CarlosNinaOchoa/yachaq-robot/documentacion/docs/img/pie-03.jpg

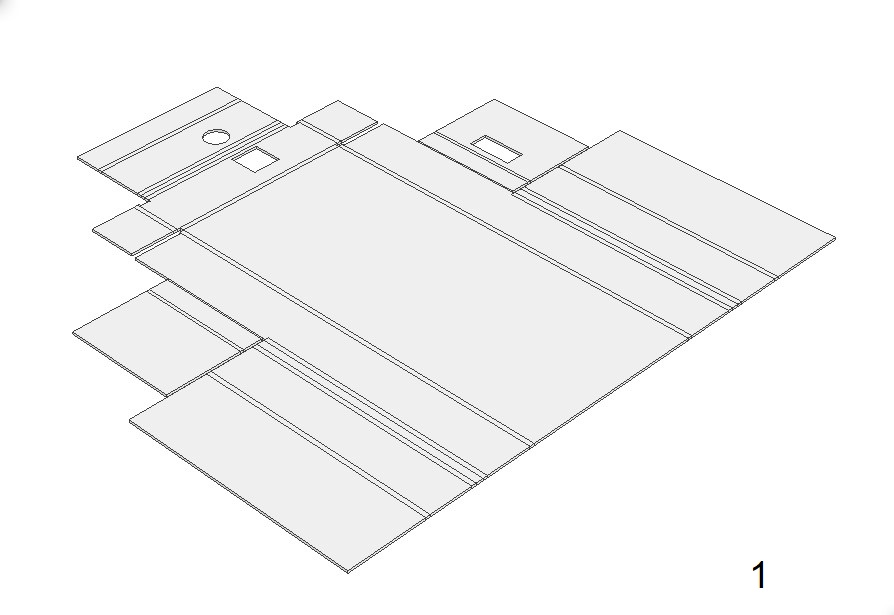
documentacion/docs/img/pie-03.jpg
