CarlosNinaOchoa/yachaq-robot/documentacion/docs/img/pie-04.jpg

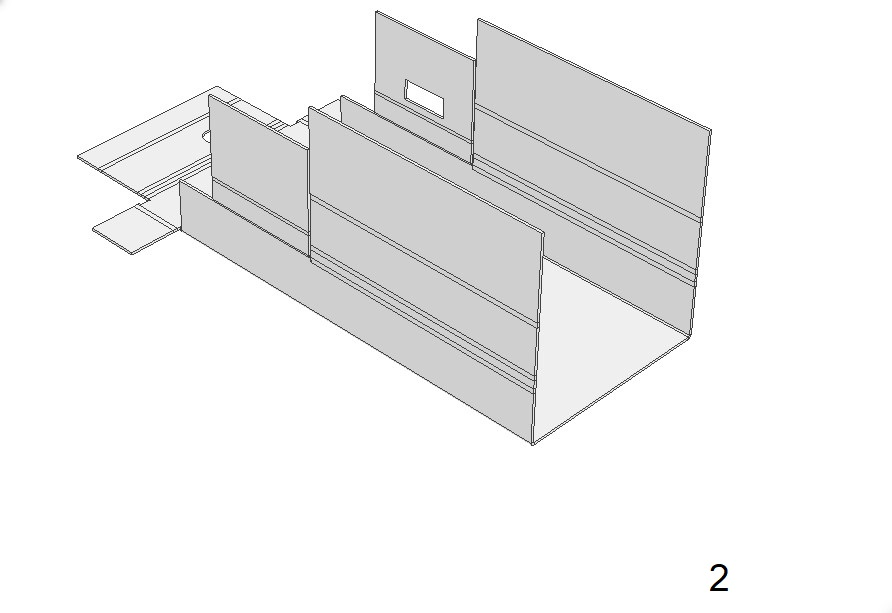
documentacion/docs/img/pie-04.jpg
