CarlosNinaOchoa/yachaq-robot/documentacion/docs/img/pie-07.jpg

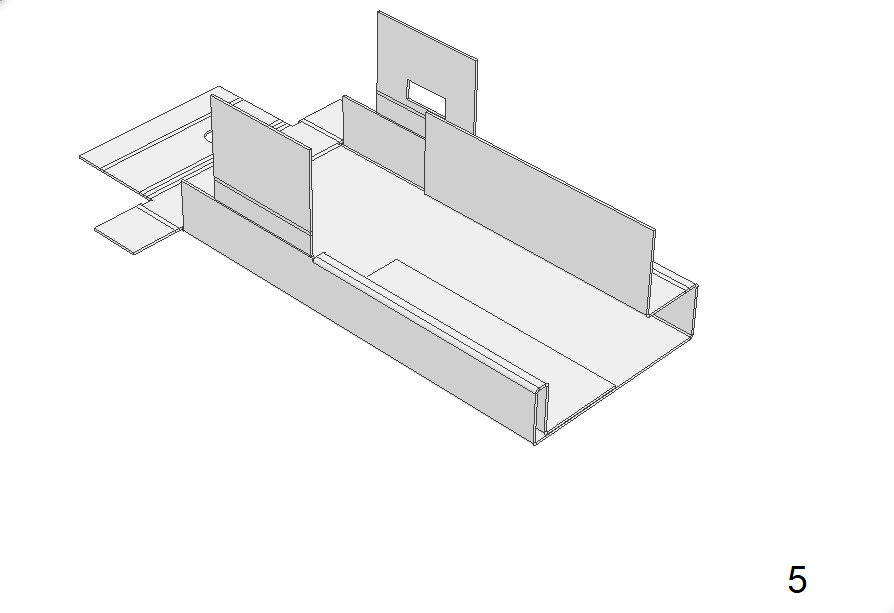
documentacion/docs/img/pie-07.jpg
