CarlosNinaOchoa/yachaq-robot/documentacion/docs/img/pie-09.jpg

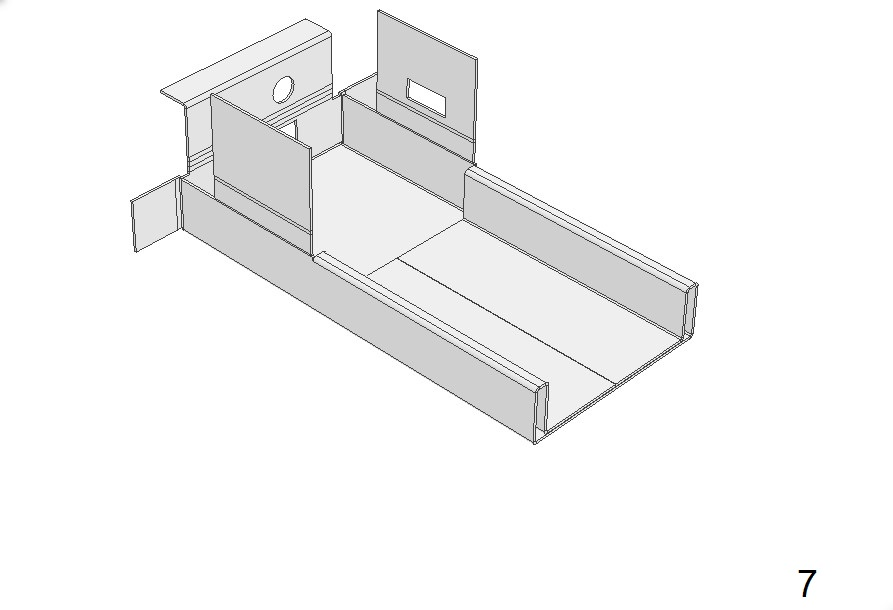
documentacion/docs/img/pie-09.jpg
