CarlosNinaOchoa/yachaq-robot/documentacion/docs/img/repository-header.png

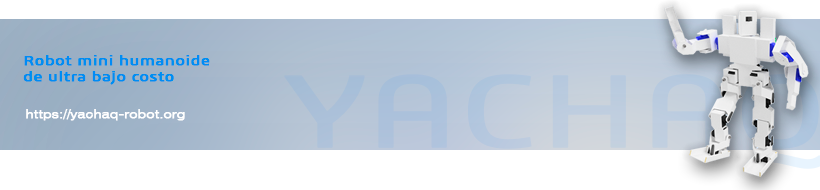
documentacion/docs/img/repository-header.png
