CarlosNinaOchoa/yachaq-robot/documentacion/docs/img/servos-mg90s-driver-esp32-cam.jpg

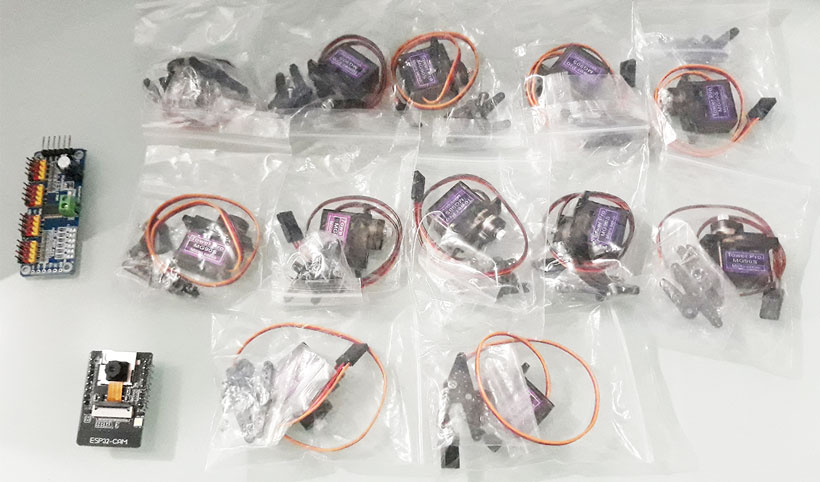
documentacion/docs/img/servos-mg90s-driver-esp32-cam.jpg
