CarlosNinaOchoa/yachaq-robot/documentacion/docs/construccion-4.md

---
page_title: Inicio
page_description: Yachaq, busca democratizar la robótica humanoide, mediante un hardware de ultra bajo costo.
page_author: Carlos Nina Ochoa, Roxana Gómez Romero
page_date: 2021-07-05
---

# Etapa 4: Ensamblaje

Aún estamos construyendo este contenido, por favor vuelva pronto.

Nombres de servos
