CarlosNinaOchoa/yachaq-robot/mecanica/MiniHumanoidLowCostRobot-v1.1-General-Assembly.pdf

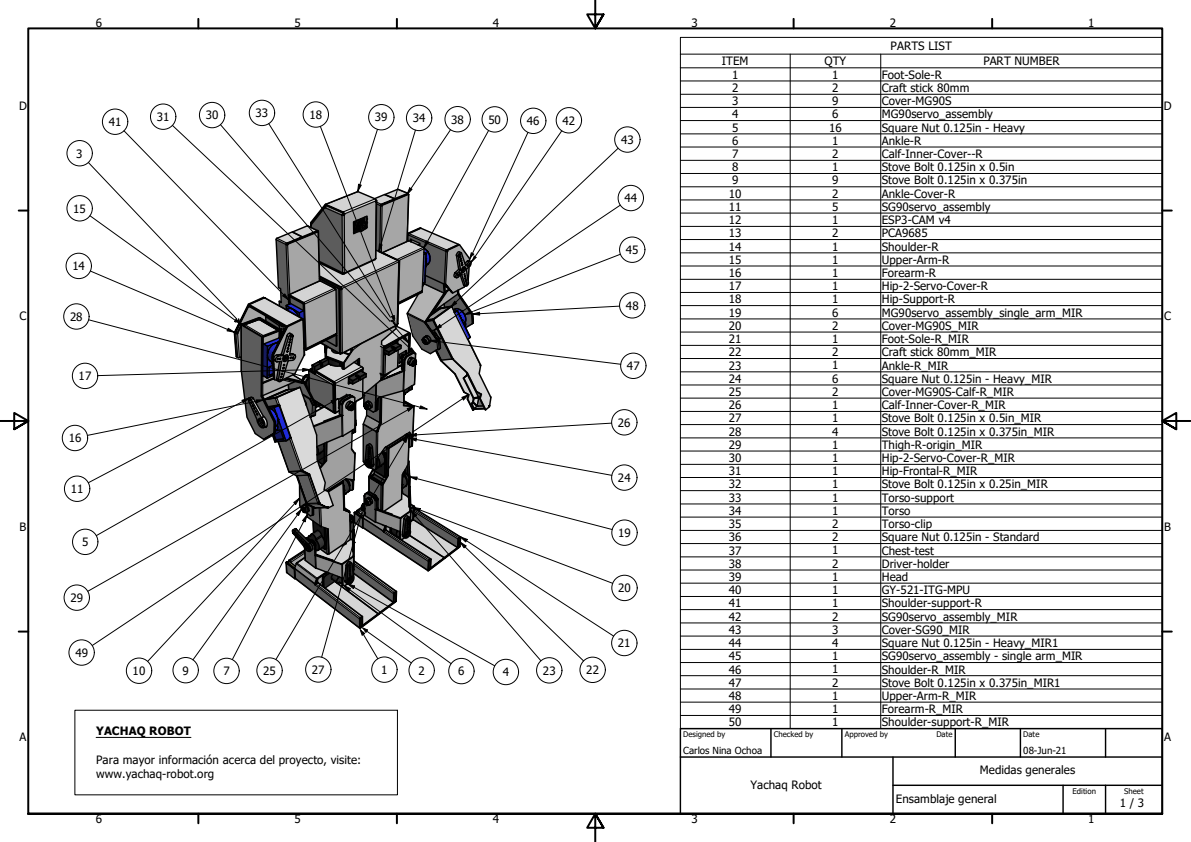
[picture p32: page 1]

I T E M | Q T Y | P A R T N U M B E R
1 | 1 | F o o t -S ole -R
2 | 2 | C r a ft s t i c k 8 0 m m
3 | 9 | C o v e r -M G 9 0 S
4 | 6 | M G 9 0 s e r v o _ a s s e m bly
5 | 1 6 | S q u a r e N u t 0 . 1 2 5 i n -H e a v y
6 | 1 | A n kle -R
7 | 2 | C alf -I n n e r -C o v e r --R
8 | 1 | S t o v e B olt 0 . 1 2 5 i n x 0 . 5 i n
9 | 9 | S t o v e B olt 0 . 1 2 5 i n x 0 . 3 7 5 i n
1 0 | 2 | A n kle -C o v e r -R
1 1 | 5 | S G 9 0 s e r v o _ a s s e m bly
1 2 | 1 | E S P 3 -C A M v 4
1 3 | 2 | P C A 9 6 8 5
1 4 | 1 | S h o uld e r -R
1 5 | 1 | U p p e r -A r m -R

1 6 | 1 | F o r e a r m -R
1 7 | 1 | H i p -2 -S e r v o -C o v e r -R
1 8 | 1 | H i p -S u p p o r t -R
1 9 | 6 | M G 9 0 s e r v o _ a s s e m bly _ s i n gle _ a r m _ M I R
2 0 | 2 | C o v e r -M G 9 0 S _ M I R
2 1 | 1 | F o o t -S ole -R_ M I R
2 2 | 2 | C r a ft s t i c k 8 0 m m _ M I R
2 3 | 1 | A n kle -R_ M I R
2 4 | 6 | S q u a r e N u t 0 . 1 2 5 i n -H e a v y_ M I R
2 5 | 2 | C o v e r -M G 9 0 S -C alf -R_ M I R
2 6 | 1 | C alf -I n n e r -C o v e r -R_ M I R
2 7 | 1 | S t o v e B olt 0 . 1 2 5 i n x 0 . 5 i n _ M I R
2 8 | 4 | S t o v e B olt 0 . 1 2 5 i n x 0 . 3 7 5 i n _ M I R
2 9 | 1 | T h i g h -R -o r i g i n _ M I R
3 0 | 1 | H i p -2 -S e r v o -C o v e r -R_ M I R
3 1 | 1 | H i p -F r o n t al-R_ M I R
3 2 | 1 | S t o v e B olt 0 . 1 2 5 i n x 0 . 2 5 i n _ M I R
3 3 | 1 | T o r s o -s u p p o r t
3 4 | 1 | T o r s o
3 5 | 2 | T o r s o -cli p
3 6 | 2 | S q u a r e N u t 0 . 1 2 5 i n -S t a n d a r d
3 7 | 1 | C h e s t -t e s t
3 8 | 2 | D r i v e r -h old e r
3 9 | 1 | H e a d
4 0 | 1 | G Y -5 2 1 -I T G -M P U
4 1 | 1 | S h o uld e r -s u p p o r t -R
4 2 | 2 | S G 9 0 s e r v o _ a s s e m bly_ M I R
4 3 | 3 | C o v e r -S G 9 0 _ M I R
4 4 | 4 | S q u a r e N u t 0 . 1 2 5 i n -H e a v y_ M I R 1

4 5 | 1 | S G 9 0 s e r v o _ a s s e m bly -s i n gle a r m _ M I R
4 6 | 1 | S h o uld e r -R_ M I R
4 7 | 2 | S t o v e B olt 0 . 1 2 5 i n x 0 . 3 7 5 i n _ M I R 1
4 8 | 1 | U p p e r -A r m -R_ M I R
4 9 | 1 | F o r e a r m -R_ M I R
5 0 | 1 | S h o uld e r -s u p p o r t -R_ M I R

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

M e d i d a s g e n e r ale s

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

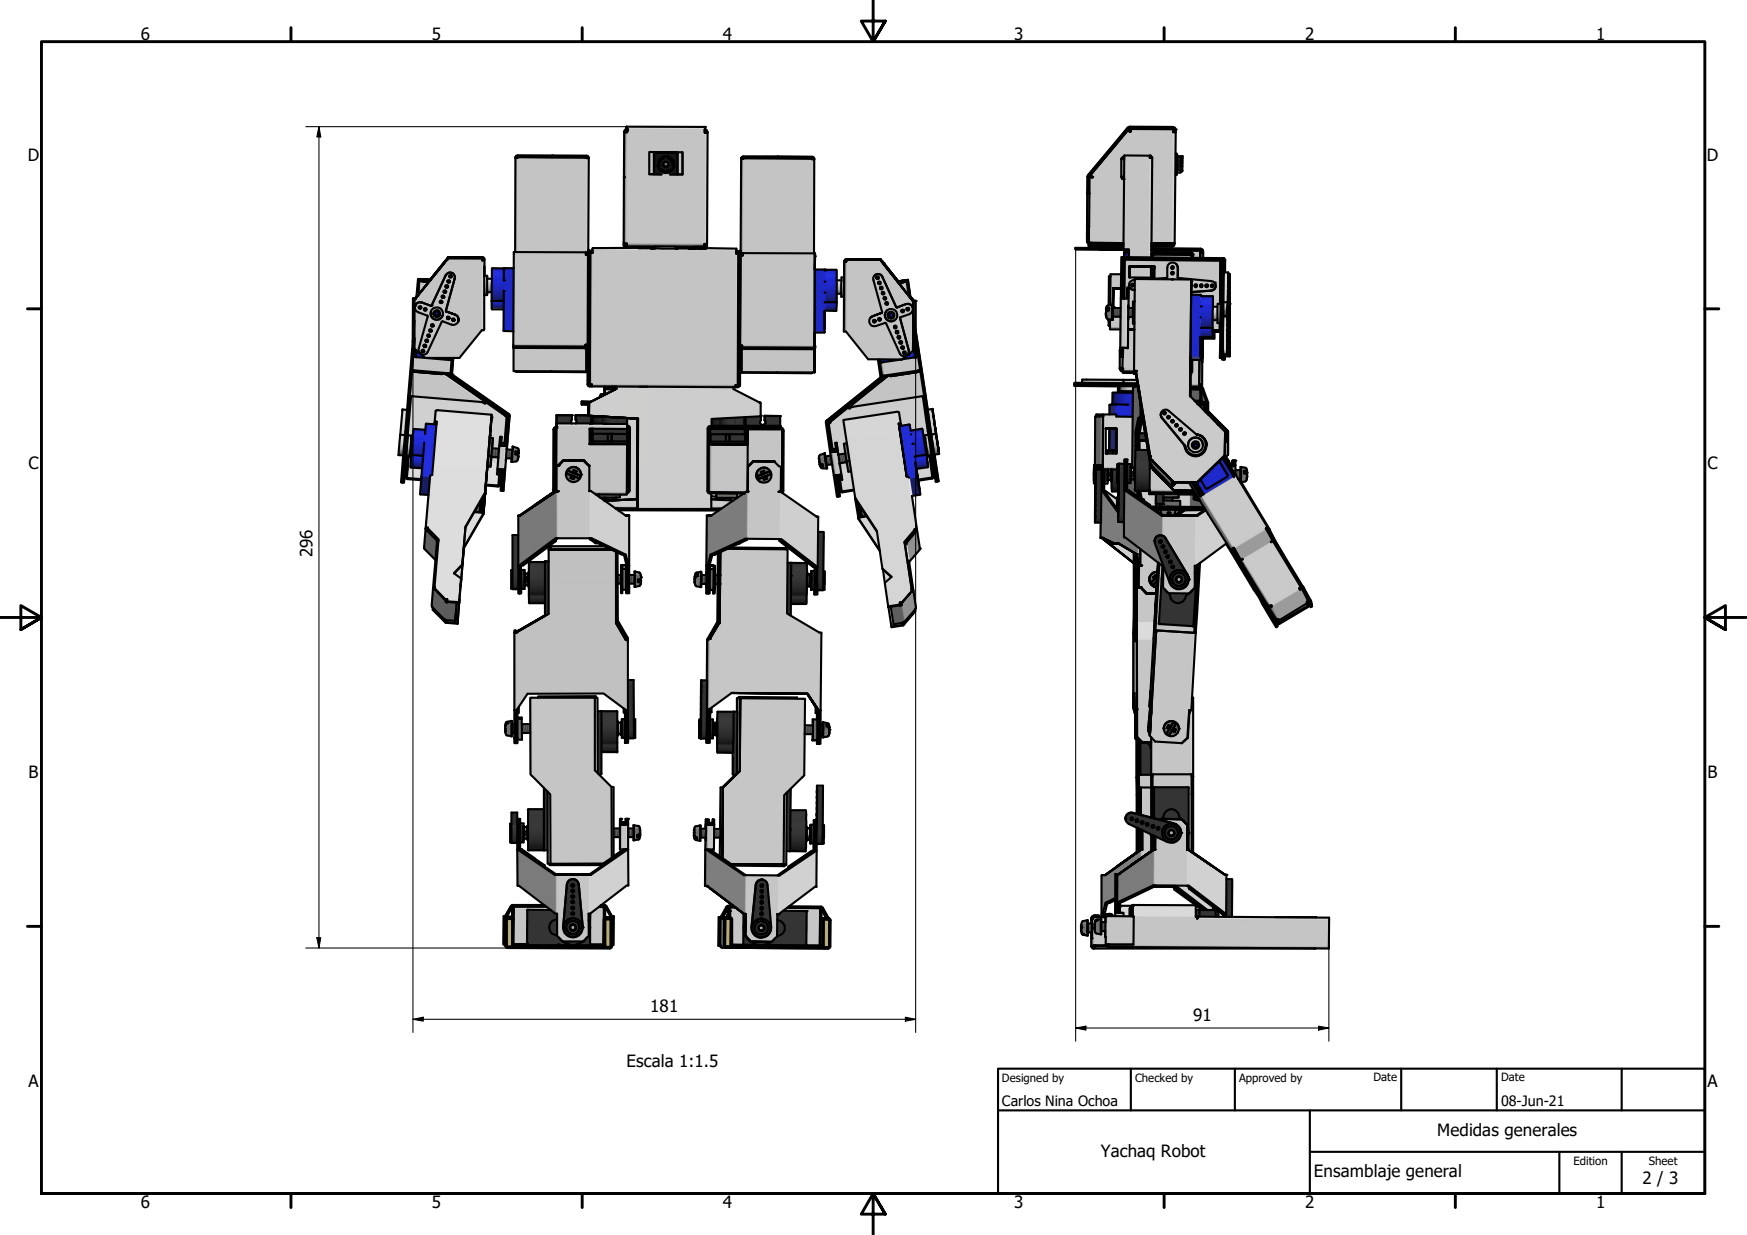
[picture p33: page 2]
Medidas generales; Ensamblaje general; Yachaq Robot; Carlos Nina Ochoa; 08-Jun-21; Designed by; Checked by; Approved by; Date; Escala 1:1.5

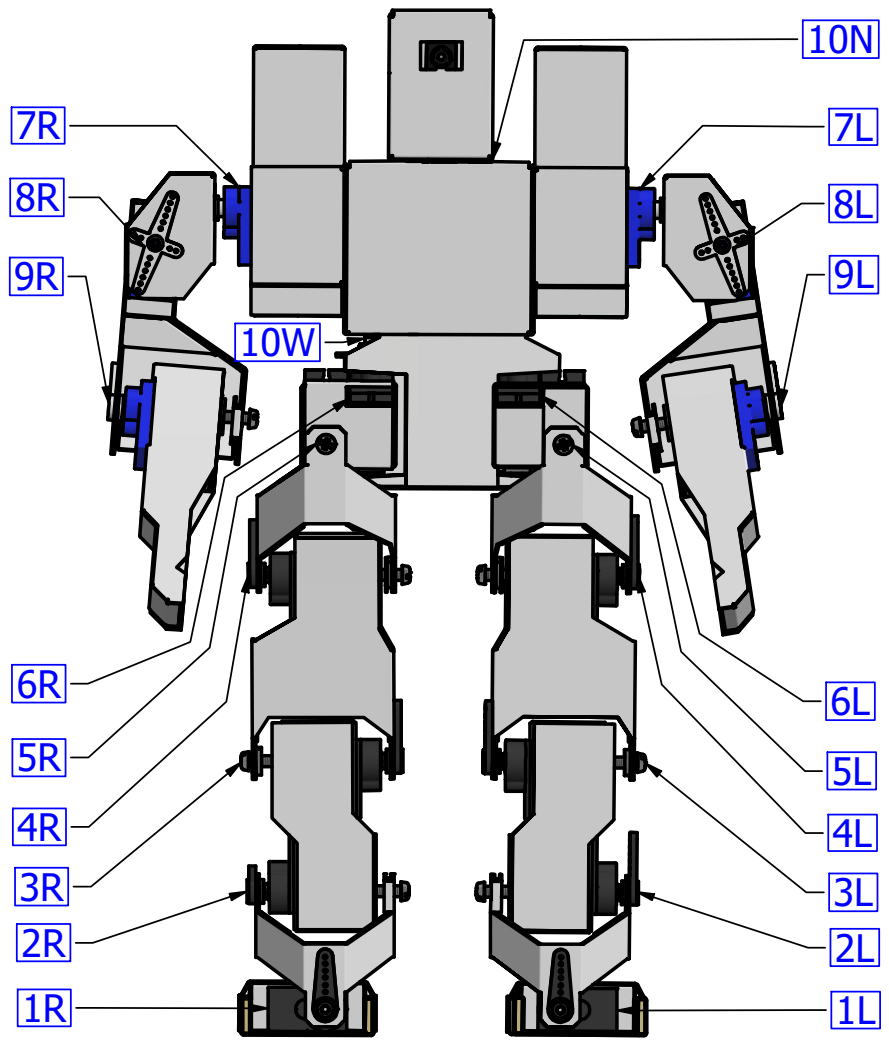
[picture p34: page 3]

Designed by Carlos Nina Ochoa | Checked by | Approved by Date | Date 08-Jun-21

Yachaq Robot | Medidas generales

Ensamblaje general | Edition | Sheet 3 / 3
