CarlosNinaOchoa/yachaq-robot/documentacion/docs/img/calibracion-01.jpg

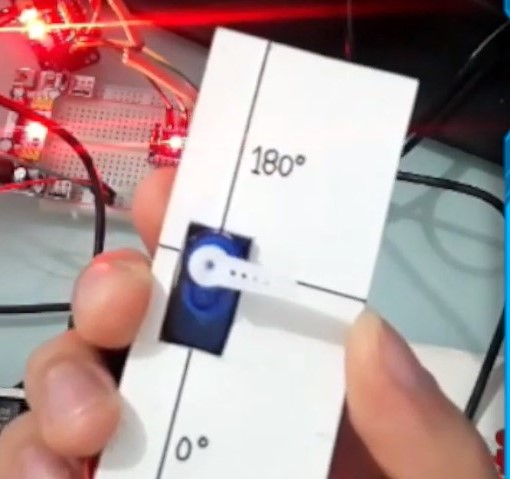
documentacion/docs/img/calibracion-01.jpg
