CarlosNinaOchoa/yachaq-robot/mecanica/Plantillas de corte v1 - Yachaq robot v1.3.pdf

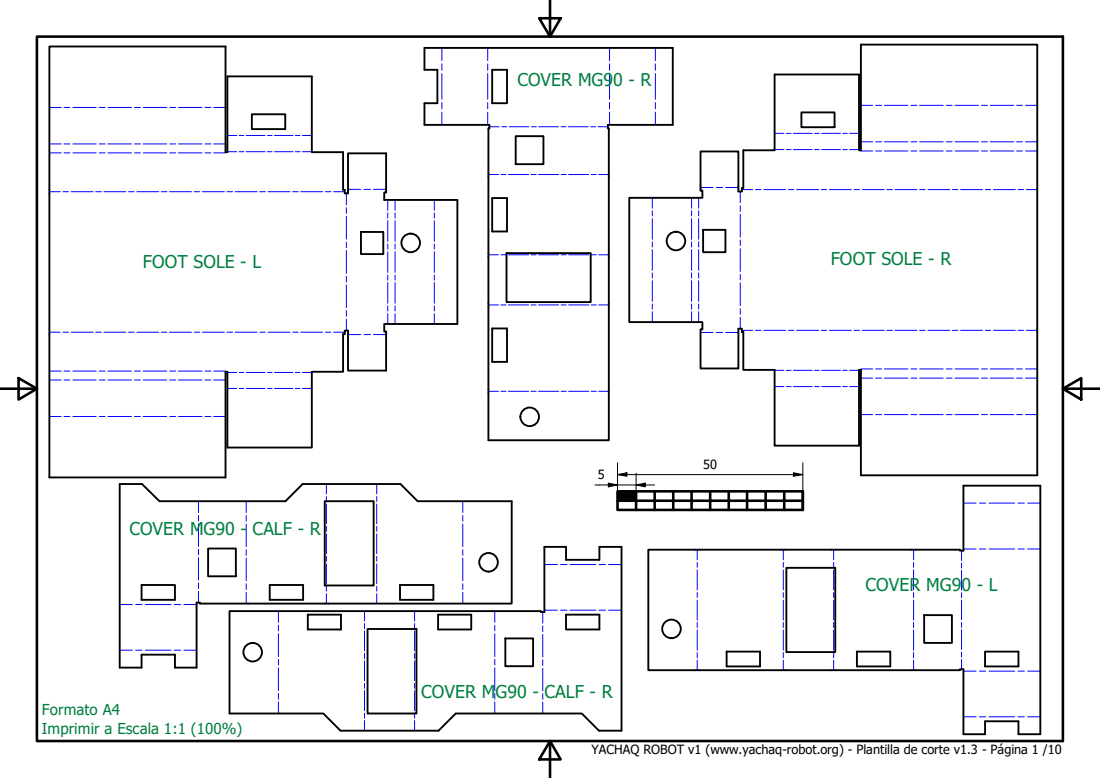
[picture p36: page 1]
FOOT SOLE - L; FOOT SOLE - R; COVER MG90 - R; COVER MG90 - L; COVER MG90 - CALF - R; Formato A4 Imprimir a Escala 1:1 (100%)

YACHAQ ROBOT v1 (www.yachaq-robot.org) - Plantilla de corte v1.3 - Pigina 1 /10

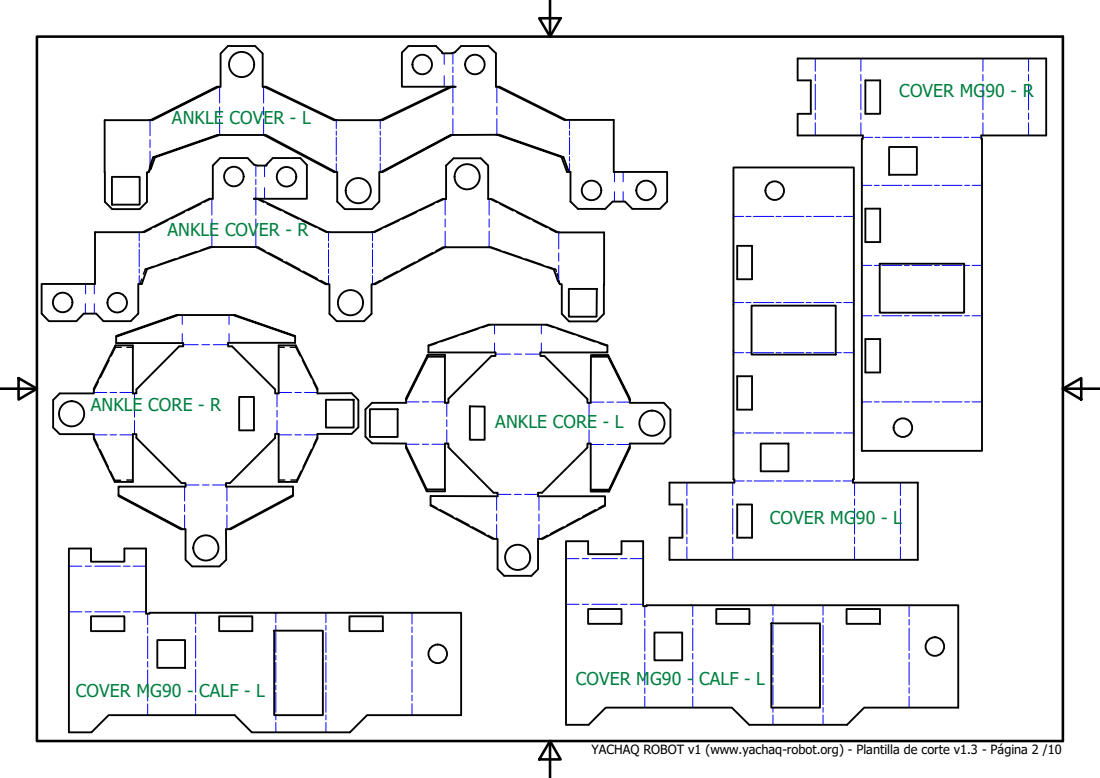
[picture p37: page 2]
ANKLE COVER - L; ANKLE COVER - R; ANKLE CORE - R; ANKLE CORE - L; COVER MG90 - R; COVER MG90 - L; COVER MG90 - CALF - L; COVER MG90 -; CALF - L

YACHAQ ROBOT v1 (www.yachaq-robot.org) - Plantilla de corte v1.3 - Pigina 2 /10

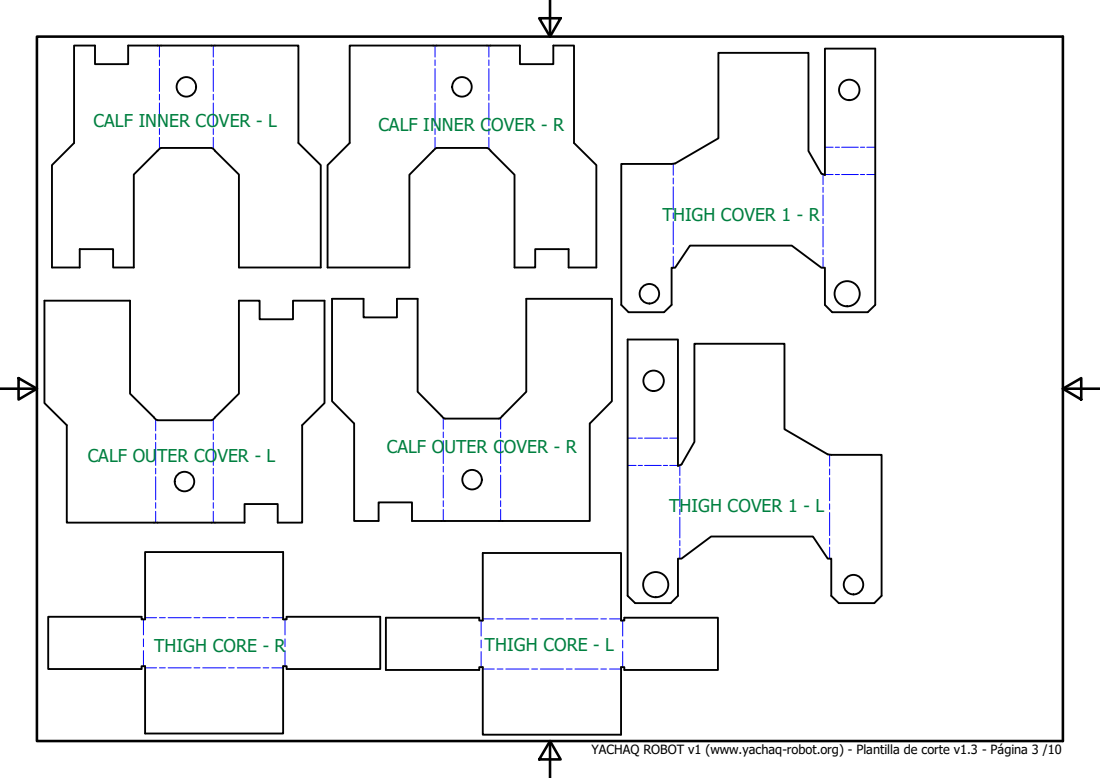
[picture p38: page 3]
CALF INNER COVER - L; CALF INNER COVER -; THIGH CORE - R; THIGH CORE - L; THIGH COVER 1 - R; THIGH COVER 1 - L

CALF OUTER COVER - R

CALF OUTER COVER - L

YACHAQ ROBOT v1 (www.yachaq-robot.org) - Plantilla de corte v1.3 - Pigina 3 /10

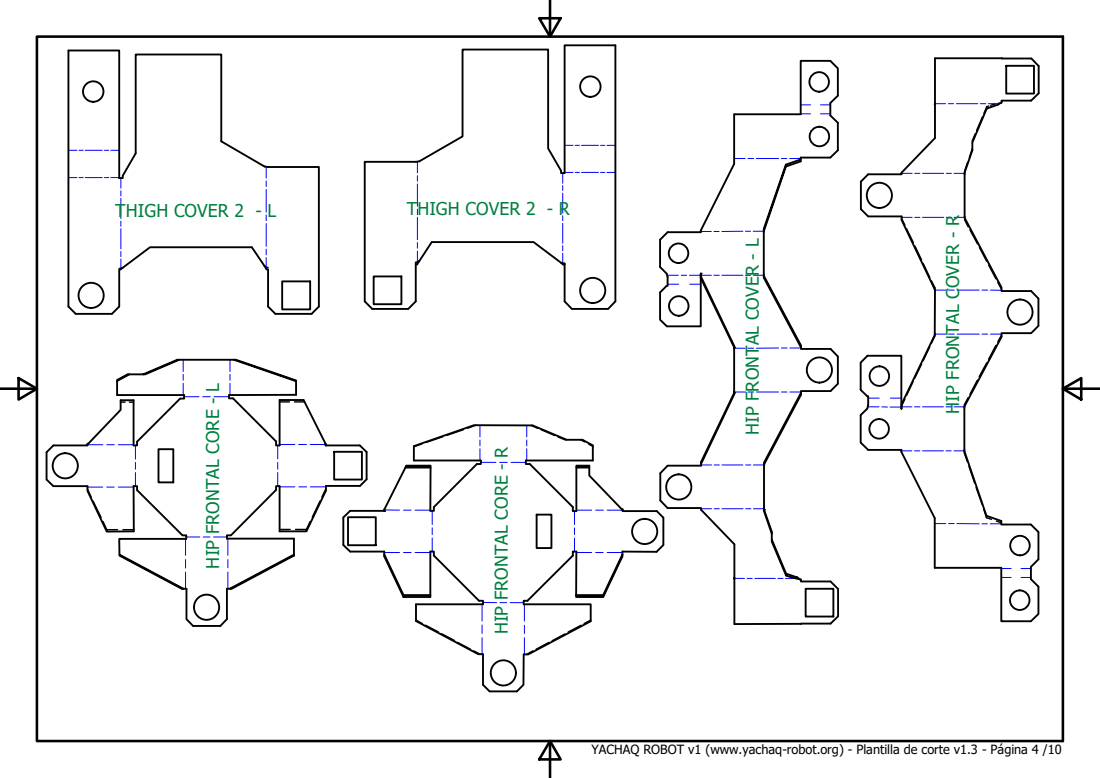
[picture p39: page 4]

HIP FRONTAL COVER - R

HIP FRONTAL COVER - L

HIP FRONTAL CORE - L

HIP FRONTAL CORE - R

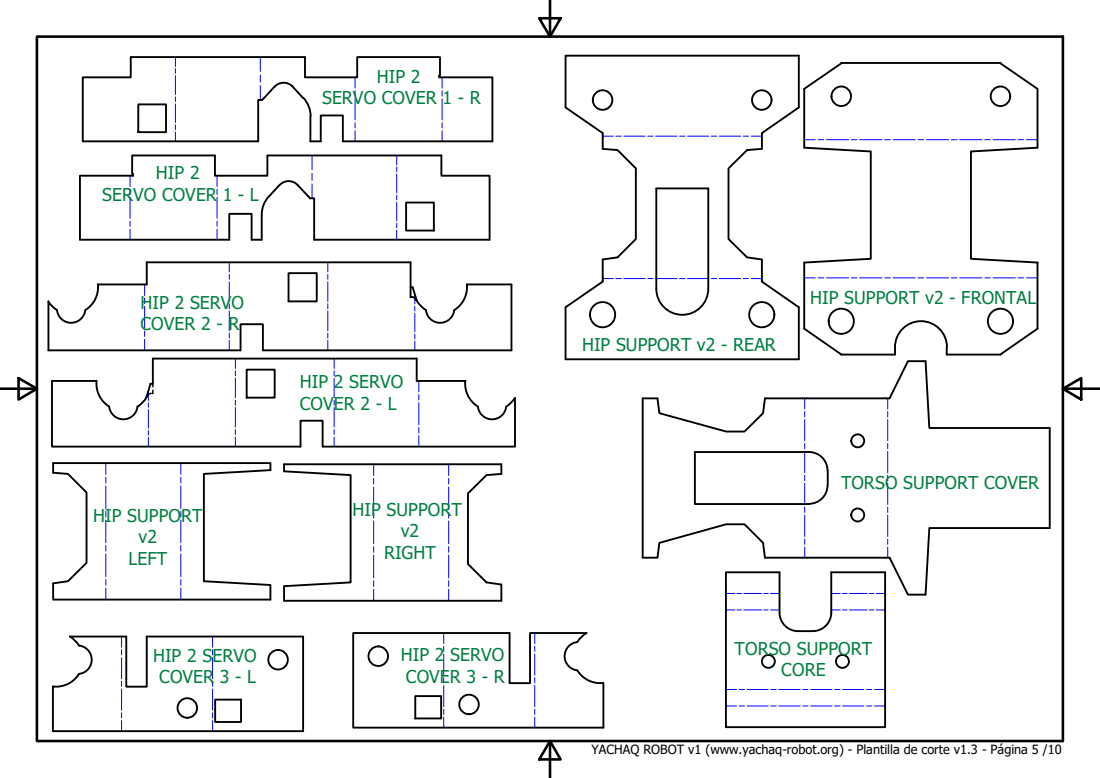
[picture p40: page 5]
HIP 2; SERVO COVER; HIP; 2 SERVO; COVER 2 - L; HIP 2 SERVO COVER 2 - R; HIP SUPPORT; TORSO SUPPORT; HIP 2 SERVO COVER 3 - L; SERVO; COVER 3 - R

HIP SUPPORT v2 - FRONTAL

HIP SUPPORT v2 - REAR

TORSO SUPPORT COVER

YACHAQ ROBOT v1 (www.yachaq-robot.org) - Plantilla de corte v1.3 - Pigina 5 /10

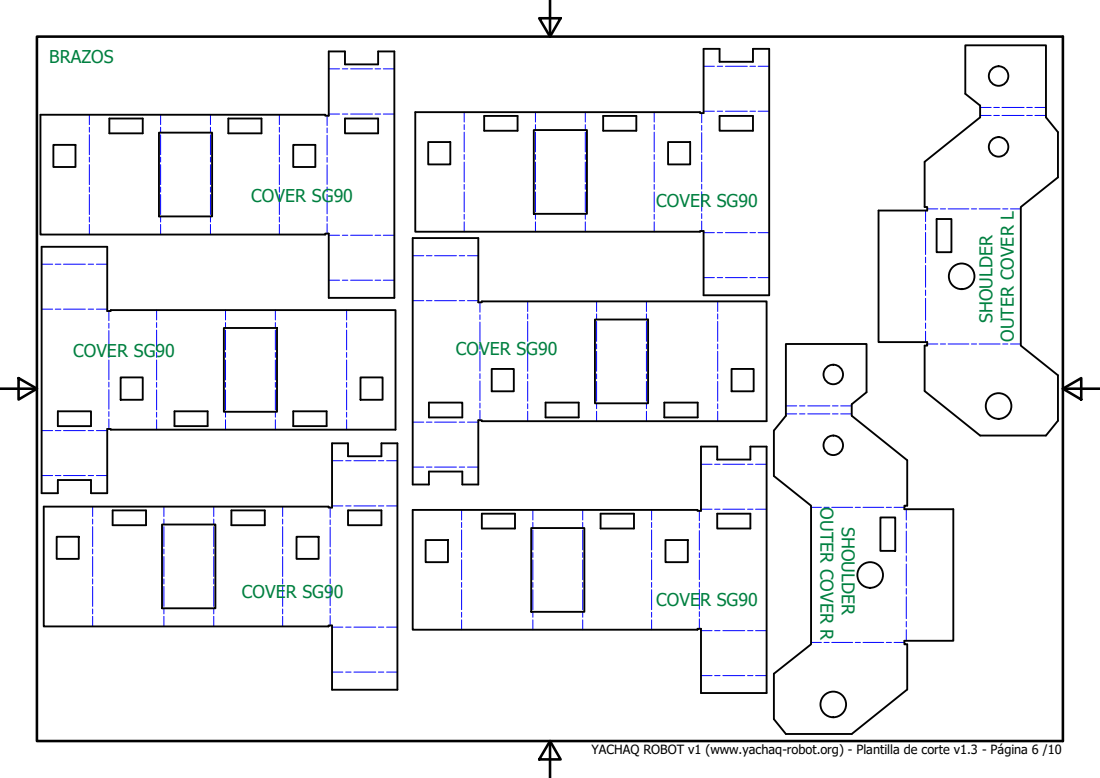
[picture p41: page 6]
COVER SG90

YACHAQ ROBOT v1 (www.yachaq-robot.org) - Plantilla de corte v1.3 - Pigina 6 /10

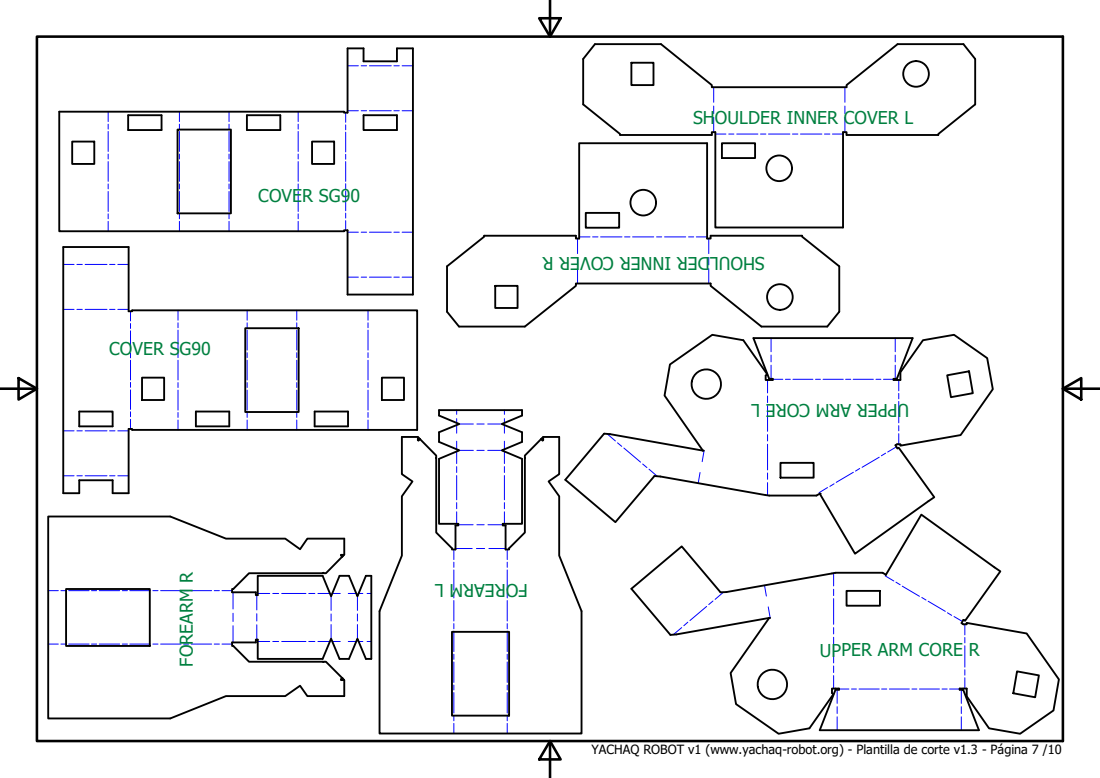
[picture p42: page 7]
COVER SG90; SHOULDER INNER; COVER L; UPPER ARM CORE

YACHAQ ROBOT v1 (www.yachaq-robot.org) - Plantilla de corte v1.3 - Pigina 7 /10

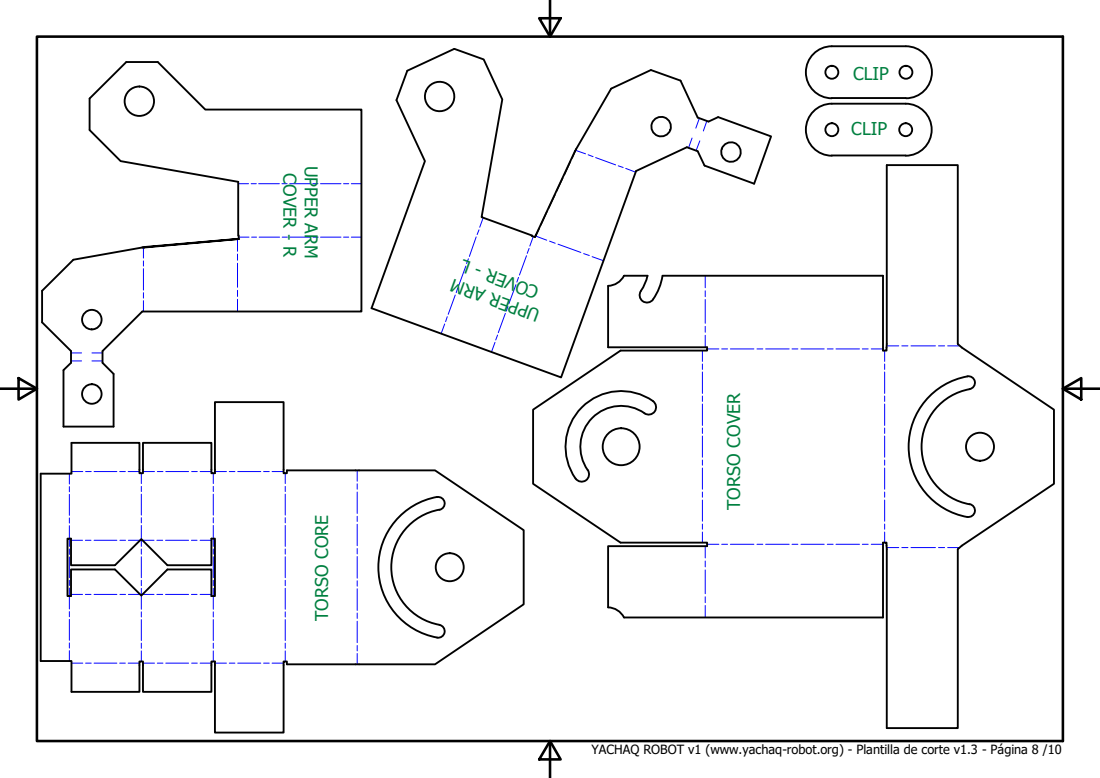
[picture p43: page 8]

YACHAQ ROBOT v1 (www.yachaq-robot.org) - Plantilla de corte v1.3 - Pigina 8 /10

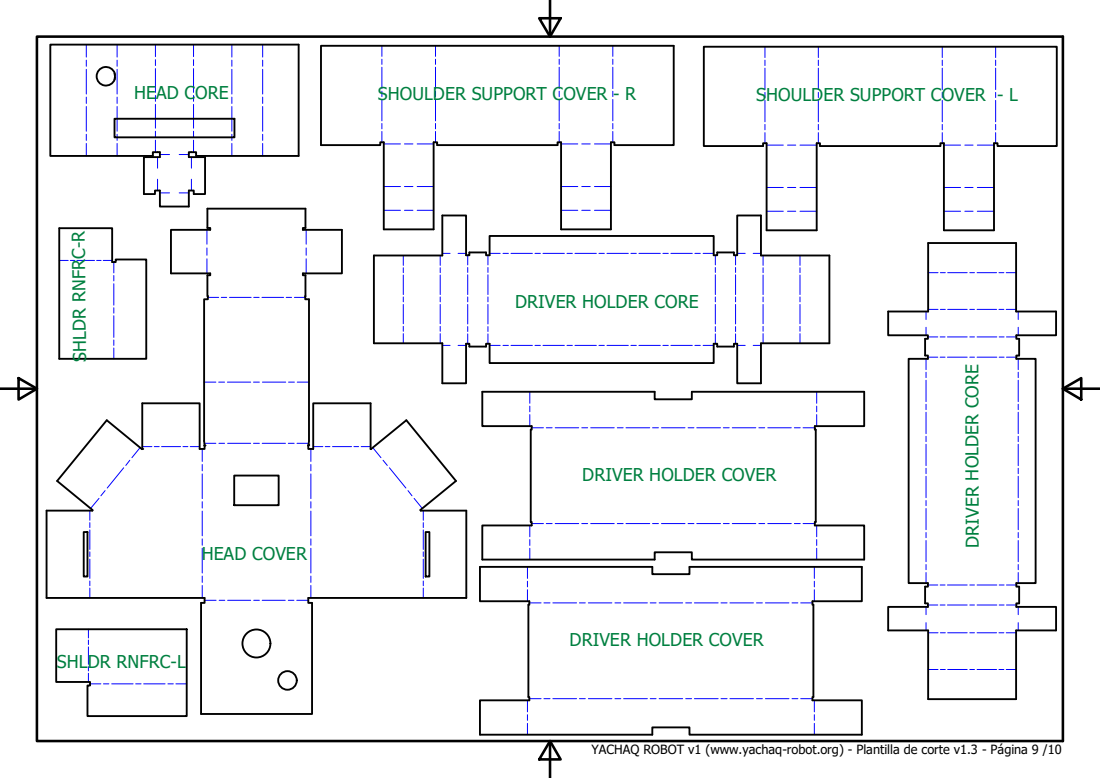
[picture p44: page 9]
HEAD CORE; HEAD COVER; SHOULDER SUPPORT COVER; SHOULDER SUPPORT COVER - L; SHLDR RNFRC-L

DRIVER HOLDER CORE

DRIVER HOLDER COVER

YACHAQ ROBOT v1 (www.yachaq-robot.org) - Plantilla de corte v1.3 - Pigina 9 /10

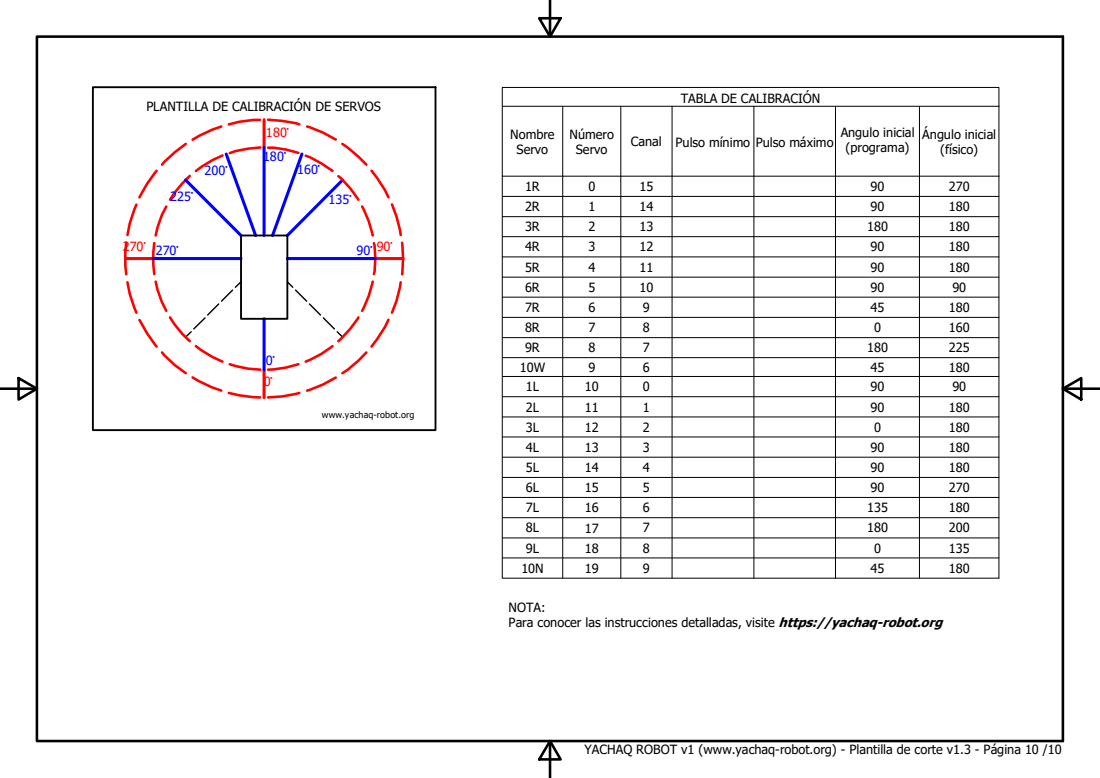
[picture p45: page 10]

PLANTILLA DE CALIBRACIÏN DE SERVOS

TABLA DE CALIBRACIÏN

Nombre Servo | N~mero Servo | Canal | Pulso mtnimo | Pulso miximo | Angulo inicial (programa) | Èngulo inicial (ftsico)

1R | 0 | 15 | | | 90 | 270
2R | 1 | 14 | | | 90 | 180
3R | 2 | 13 | | | 180 | 180
4R | 3 | 12 | | | 90 | 180
5R | 4 | 11 | | | 90 | 180
6R | 5 | 10 | | | 90 | 90
7R | 6 | 9 | | | 45 | 180
8R | 7 | 8 | | | 0 | 160
9R | 8 | 7 | | | 180 | 225
10W | 9 | 6 | | | 45 | 180
1L | 10 | 0 | | | 90 | 90
2L | 11 | 1 | | | 90 | 180
3L | 12 | 2 | | | 0 | 180
4L | 13 | 3 | | | 90 | 180
5L | 14 | 4 | | | 90 | 180
6L | 15 | 5 | | | 90 | 270
7L | 16 | 6 | | | 135 | 180
8L | 17 | 7 | | | 180 | 200
9L | 18 | 8 | | | 0 | 135
10N | 19 | 9 | | | 45 | 180

www.yachaq-robot.org

NOTA:
Para conocer las instrucciones detalladas, visite https://yachaq-robot.org

YACHAQ ROBOT v1 (www.yachaq-robot.org) - Plantilla de corte v1.3 - Pigina 10 /10
