CarlosNinaOchoa/yachaq-robot/(commit log)

2021-06-19 Plantillas de corte actualizadas a la version 1.2
2021-07-04 Video de talleres agregados a Readme
2021-07-12 primeras imagenes y pagina de bienvenida creadas
2021-07-12 instrucciones de calibración iniciadas, plantillas de corte actualizadas
2021-07-14 procedimiento de calibracion de servos agregado a la documentacion
2021-07-21 documentacion incluye videos de pie y tobillo
2021-07-22 videos de ensamble de piernas agregados a docs
2021-07-22 Armado de cadera documentado con video
